duodiscus92/projet-gonogo/kicad/gonogo-light/gonogo-light.jpg

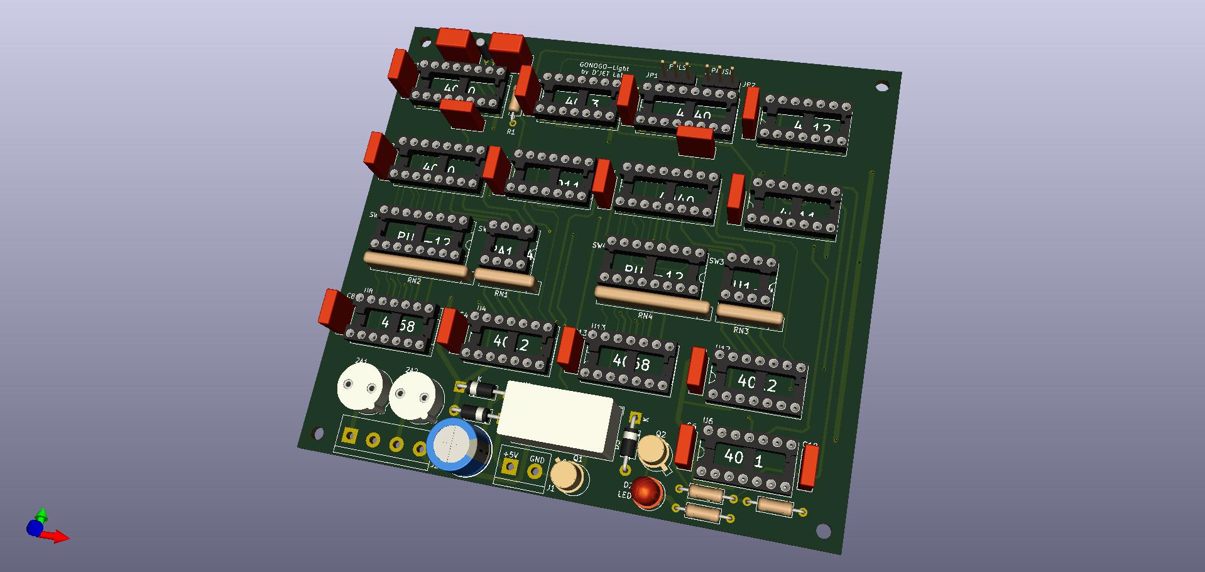
kicad/gonogo-light/gonogo-light.jpg
