duodiscus92/projet-gonogo/kicad/gonogo-heavy/gonogo-heavy.jpg

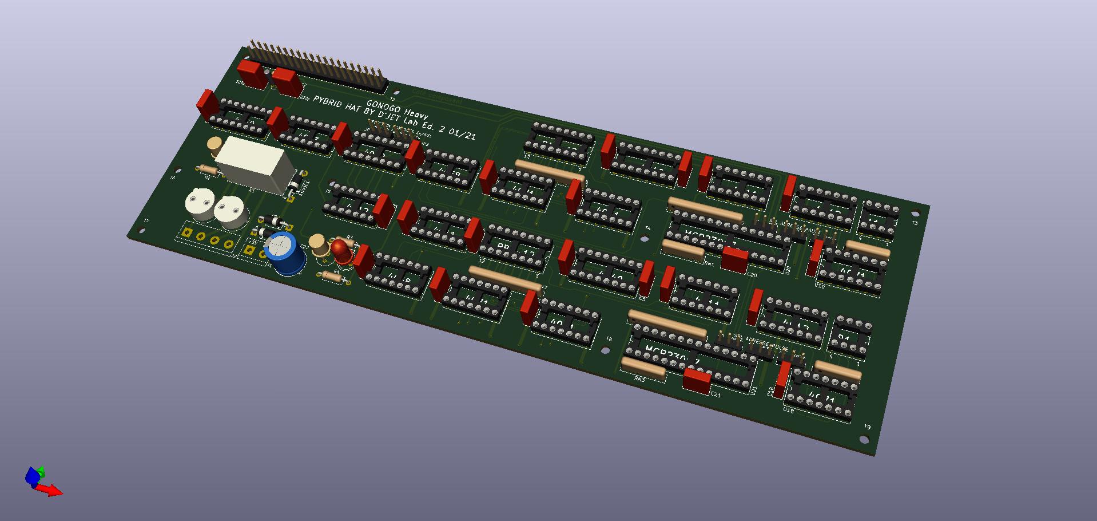
kicad/gonogo-heavy/gonogo-heavy.jpg
