duodiscus92/projet-gonogo/kicad/gonogo-upduino/gonogo-upduino/gongo.png

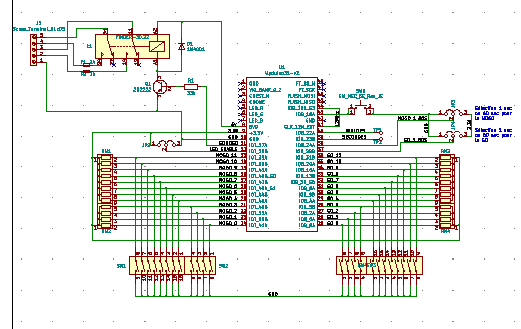
kicad/gonogo-upduino/gonogo-upduino/gongo.png
