duodiscus92/projet-gonogo/kicad/gonogo-upduino/gonogo-upduino/upduino-pinout.png

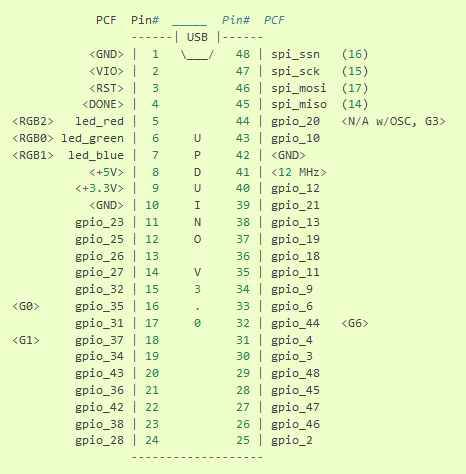
kicad/gonogo-upduino/gonogo-upduino/upduino-pinout.png
