duodiscus92/projet-gonogo/kicad/gonogo-upduino/gonogo-upduino/gonogo-upduino.kicad_pcb

## KiCad design kicad/gonogo-upduino/gonogo-upduino/gonogo-upduino.kicad_pcb (2022-09-14)

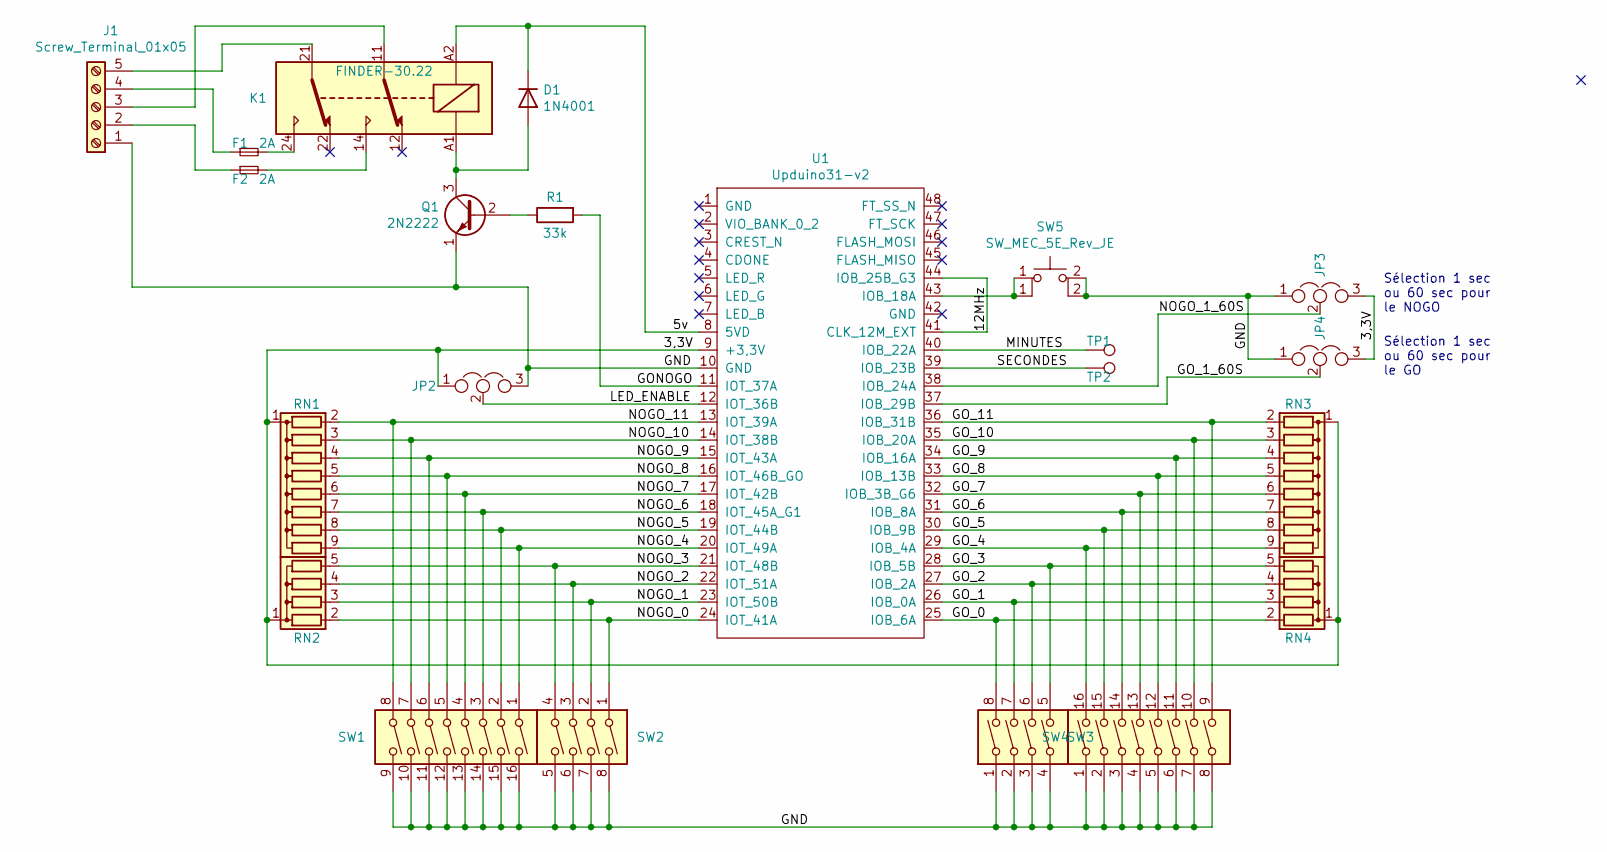
[picture p17: schematic gonogo-upduino.sch]

Parts:
D1: 1N4001; D_DO-41_SOD81_P10.16mm_Horizontal
F1, F2: 2A; Fuseholder_TR5_Littelfuse_No560_No460
J1: Screw_Terminal_01x05; TerminalBlock_bornier-5_P5.08mm
JP2, JP3, JP4: Jumper_NC_Dual; PinHeader_1x03_P2.54mm_Vertical
K1: FINDER-30.22; Relay_DPDT_Finder_30.22
Q1: 2N2222; TO-18-3
R1: 33k; R_Axial_DIN0207_L6.3mm_D2.5mm_P2.54mm_Vertical
RN1, RN3: R_Network08; R_Array_SIP9
RN2, RN4: R_Network04; R_Array_SIP5
SW1, SW4: SW_DIP_x08; DIP-16_W7.62mm_Socket
SW2, SW3: SW_DIP_x04; DIP-8_W7.62mm_Socket
SW5: SW_MEC_5E_Rev_JE; SW_PUSH_6mm
TP1, TP2: TestPoint; TestPoint_THTPad_3.0x3.0mm_Drill1.5mm
U1: Upduino31-v2; DIP-48_W17.78mm_LongPads

Connections:
/3,3V: JP2.1, JP3.3, JP4.3, RN1.1 (common), RN2.1 (common), RN3.1 (common), RN4.1 (common), U1.9 (+3,3V)
/5v: D1.1 (K), K1.A2, U1.8 (5VD)
/12MHz: U1.41 (CLK_12M_EXT), U1.44 (IOB_25B_G3)
/GND: J1.1, JP2.3, JP3.1, JP4.1, Q1.1 (E), SW1.9, SW1.10, SW1.11, SW1.12, SW1.13, SW1.14, SW1.15, SW1.16, SW2.5, SW2.6, SW2.7, SW2.8, SW3.1, SW3.2, SW3.3, SW3.4, SW4.1, SW4.2, SW4.3, SW4.4, SW4.5, SW4.6, SW4.7, SW4.8, SW5.2 (A), U1.10 (GND)
/GONOGO: R1.2, U1.11 (IOT_37A)
/GO_0: RN4.2 (R1), SW3.8, U1.25 (IOB_6A)
/GO_1: RN4.3 (R2), SW3.7, U1.26 (IOB_0A)
/GO_1_60S: JP4.2, U1.37 (IOB_29B)
/GO_2: RN4.4 (R3), SW3.6, U1.27 (IOB_2A)
/GO_3: RN4.5 (R4), SW3.5, U1.28 (IOB_5B)
/GO_4: RN3.9 (R8), SW4.16, U1.29 (IOB_4A)
/GO_5: RN3.8 (R7), SW4.15, U1.30 (IOB_9B)
/GO_6: RN3.7 (R6), SW4.14, U1.31 (IOB_8A)
/GO_7: RN3.6 (R5), SW4.13, U1.32 (IOB_3B_G6)
/GO_8: RN3.5 (R4), SW4.12, U1.33 (IOB_13B)
/GO_9: RN3.4 (R3), SW4.11, U1.34 (IOB_16A)
/GO_10: RN3.3 (R2), SW4.10, U1.35 (IOB_20A)
/GO_11: RN3.2 (R1), SW4.9, U1.36 (IOB_31B)
/LED_ENABLE: JP2.2, U1.12 (IOT_36B)
/MINUTES: TP1.1, U1.40 (IOB_22A)
/NOGO_0: RN2.2 (R1), SW2.1, U1.24 (IOT_41A)
/NOGO_1: RN2.3 (R2), SW2.2, U1.23 (IOT_50B)
/NOGO_1_60S: JP3.2, U1.38 (IOB_24A)
/NOGO_2: RN2.4 (R3), SW2.3, U1.22 (IOT_51A)
/NOGO_3: RN2.5 (R4), SW2.4, U1.21 (IOT_48B)
/NOGO_4: RN1.9 (R8), SW1.1, U1.20 (IOT_49A)
/NOGO_5: RN1.8 (R7), SW1.2, U1.19 (IOT_44B)
/NOGO_6: RN1.7 (R6), SW1.3, U1.18 (IOT_45A_G1)
/NOGO_7: RN1.6 (R5), SW1.4, U1.17 (IOT_42B)
/NOGO_8: RN1.5 (R4), SW1.5, U1.16 (IOT_46B_GO)
/NOGO_9: RN1.4 (R3), SW1.6, U1.15 (IOT_43A)
/NOGO_10: RN1.3 (R2), SW1.7, U1.14 (IOT_38B)
/NOGO_11: RN1.2 (R1), SW1.8, U1.13 (IOT_39A)
/SECONDES: TP2.1, U1.39 (IOB_23B)
unnamed: D1.2 (A), K1.A1, Q1.3 (C)
unnamed: F1.1, J1.4
unnamed: F1.2, K1.24
unnamed: F2.1, J1.2
unnamed: F2.2, K1.14
unnamed: J1.3, K1.11
unnamed: J1.5, K1.21
unnamed: Q1.2 (B), R1.1
unnamed: SW5.1, U1.43 (IOB_18A)

Notes on the sheet:
Sélection 1 sec ou 60 sec pour le NOGO
Sélection 1 sec ou 60 sec pour le GO

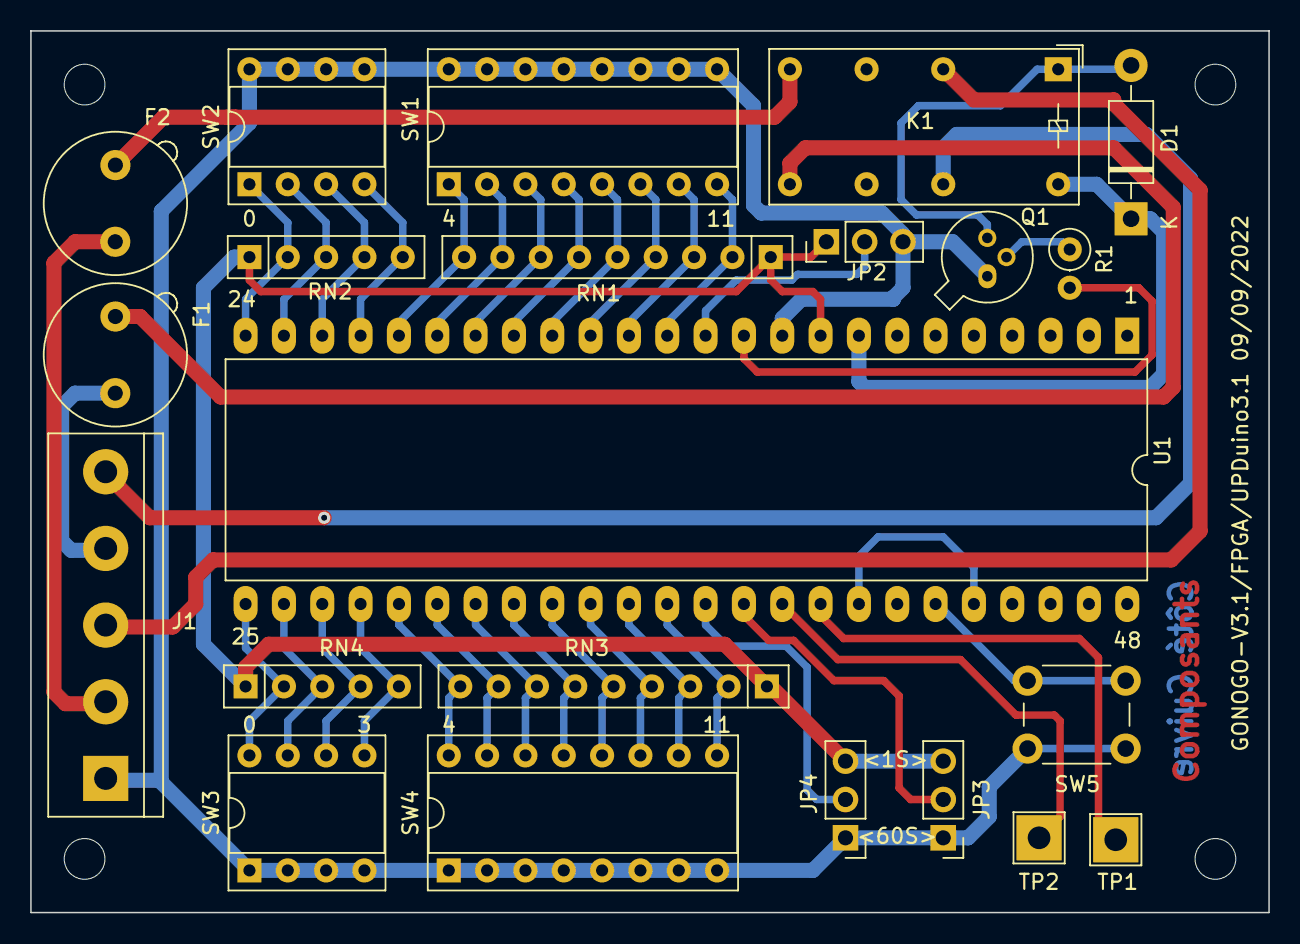
[picture p18: board gonogo-upduino.kicad_pcb from above]

Board: 2 copper layers, 82.0 x 58.4 mm, 23 parts (0 on the bottom side), 43 nets.

Other parts of the board:
NOGO-0: MountingHole_2.7mm_M2.5_DIN965
