duodiscus92/projet-gonogo/kicad/gonogo-heavy/timer-toplevel.kicad_pcb

## KiCad design kicad/gonogo-heavy/timer-toplevel.kicad_pcb (2021-02-23)

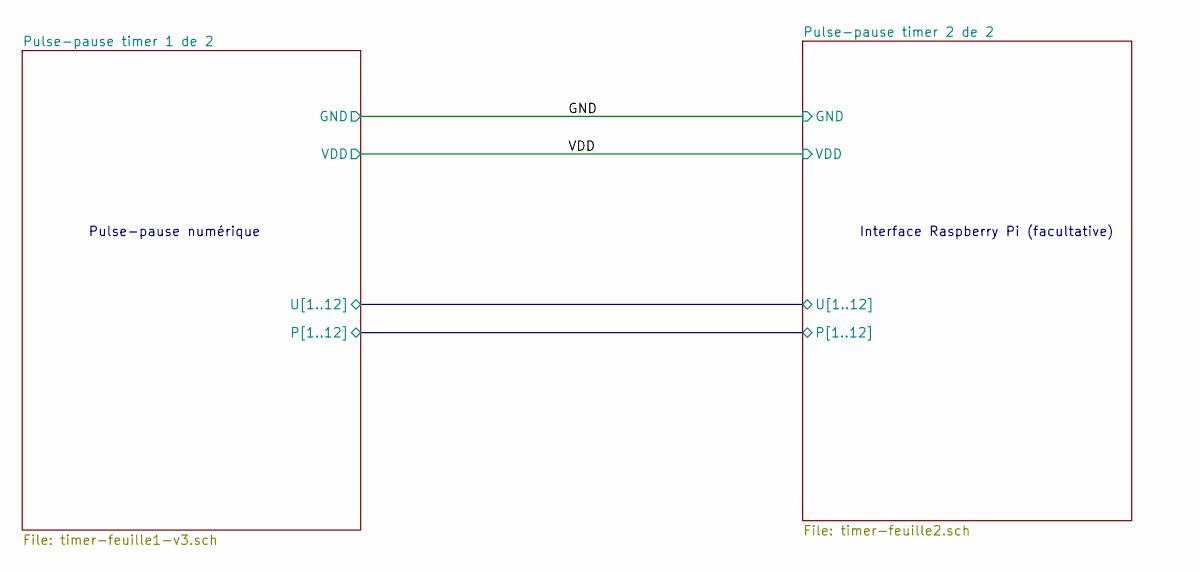
[picture p19: schematic timer-toplevel.sch, GONOGO Heavy]

Notes on the sheet:
Interface Raspberry Pi (facultative)
Pulse-pause numérique

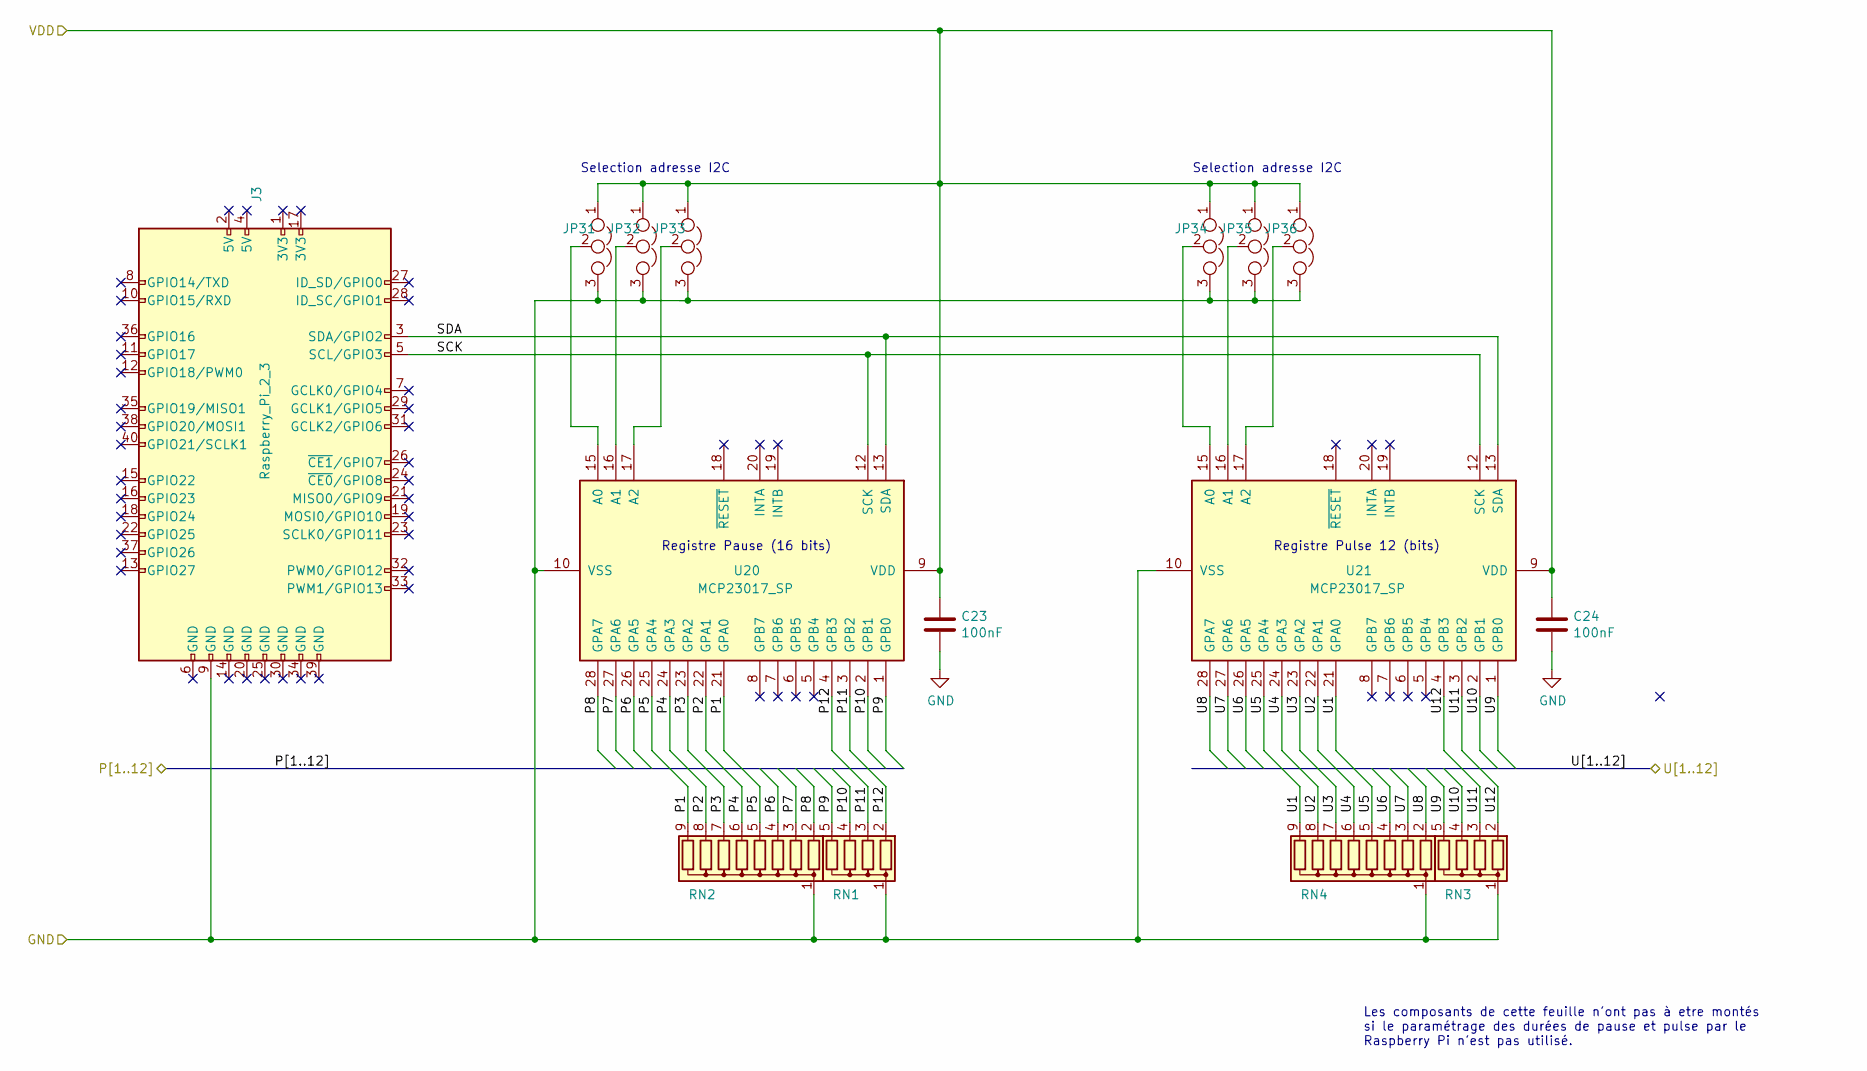
[picture p20: schematic timer-feuille2.sch, GONOGO Heavy]

Parts:
C23, C24: 100nF; C_Rect_L7.2mm_W2.5mm_P5.00mm_FKS2_FKP2_MKS2_MKP2
J3: Raspberry_Pi_2_3; PinHeader_2x20_P2.54mm_Vertical
JP31, JP32, JP33, JP34, JP35, JP36: Jumper_NC_Dual; PinHeader_1x03_P2.54mm_Vertical
RN1, RN3: R_Network04; R_Array_SIP5
RN2, RN4: R_Network08; R_Array_SIP9
U20, U21: MCP23017_SP; DIP-28_W7.62mm_Socket

Connections:
/Pulse-pause timer 1 de 2/P1: RN2.9 (R8), U20.21 (GPA0); also elsewhere on the board
/Pulse-pause timer 1 de 2/P2: RN2.8 (R7), U20.22 (GPA1); also elsewhere on the board
/Pulse-pause timer 1 de 2/P3: RN2.7 (R6), U20.23 (GPA2); also elsewhere on the board
/Pulse-pause timer 1 de 2/P4: RN2.6 (R5), U20.24 (GPA3); also elsewhere on the board
/Pulse-pause timer 1 de 2/P5: RN2.5 (R4), U20.25 (GPA4); also elsewhere on the board
/Pulse-pause timer 1 de 2/P6: RN2.4 (R3), U20.26 (GPA5); also elsewhere on the board
/Pulse-pause timer 1 de 2/P7: RN2.3 (R2), U20.27 (GPA6); also elsewhere on the board
/Pulse-pause timer 1 de 2/P8: RN2.2 (R1), U20.28 (GPA7); also elsewhere on the board
/Pulse-pause timer 1 de 2/P9: RN1.5 (R4), U20.1 (GPB0); also elsewhere on the board
/Pulse-pause timer 1 de 2/P10: RN1.4 (R3), U20.2 (GPB1); also elsewhere on the board
/Pulse-pause timer 1 de 2/P11: RN1.3 (R2), U20.3 (GPB2); also elsewhere on the board
/Pulse-pause timer 1 de 2/P12: RN1.2 (R1), U20.4 (GPB3); also elsewhere on the board
/Pulse-pause timer 1 de 2/U1: RN4.9 (R8), U21.21 (GPA0); also elsewhere on the board
/Pulse-pause timer 1 de 2/U2: RN4.8 (R7), U21.22 (GPA1); also elsewhere on the board
/Pulse-pause timer 1 de 2/U3: RN4.7 (R6), U21.23 (GPA2); also elsewhere on the board
/Pulse-pause timer 1 de 2/U4: RN4.6 (R5), U21.24 (GPA3); also elsewhere on the board
/Pulse-pause timer 1 de 2/U5: RN4.5 (R4), U21.25 (GPA4); also elsewhere on the board
/Pulse-pause timer 1 de 2/U6: RN4.4 (R3), U21.26 (GPA5); also elsewhere on the board
/Pulse-pause timer 1 de 2/U7: RN4.3 (R2), U21.27 (GPA6); also elsewhere on the board
/Pulse-pause timer 1 de 2/U8: RN4.2 (R1), U21.28 (GPA7); also elsewhere on the board
/Pulse-pause timer 1 de 2/U9: RN3.5 (R4), U21.1 (GPB0); also elsewhere on the board
/Pulse-pause timer 1 de 2/U10: RN3.4 (R3), U21.2 (GPB1); also elsewhere on the board
/Pulse-pause timer 1 de 2/U11: RN3.3 (R2), U21.3 (GPB2); also elsewhere on the board
/Pulse-pause timer 1 de 2/U12: RN3.2 (R1), U21.4 (GPB3); also elsewhere on the board
/Pulse-pause timer 2 de 2/SCK: J3.5 (SCL/GPIO3), U20.12 (SCK), U21.12 (SCK)
/Pulse-pause timer 2 de 2/SDA: J3.3 (SDA/GPIO2), U20.13 (SDA), U21.13 (SDA)
GND: C23.2, C24.2, J3.9 (GND), JP31.3, JP32.3, JP33.3, JP34.3, JP35.3, JP36.3, RN1.1 (common), RN2.1 (common), RN3.1 (common), RN4.1 (common), U20.10 (VSS), U21.10 (VSS); also elsewhere on the board
unnamed: JP31.2, U20.15 (A0)
unnamed: JP32.2, U20.16 (A1)
unnamed: JP33.2, U20.17 (A2)
unnamed: JP34.2, U21.15 (A0)
unnamed: JP35.2, U21.16 (A1)
unnamed: JP36.2, U21.17 (A2)
VDD: C23.1, C24.1, JP31.1, JP32.1, JP33.1, JP34.1, JP35.1, JP36.1, U20.9 (VDD), U21.9 (VDD); also elsewhere on the board

Notes on the sheet:
Registre Pause (16 bits)
Registre Pulse 12 (bits)
Les composants de cette feuille n'ont pas à etre montés si le paramétrage des durées de pause et pulse par le Raspberry Pi n'est pas utilisé.
Selection adresse I2C

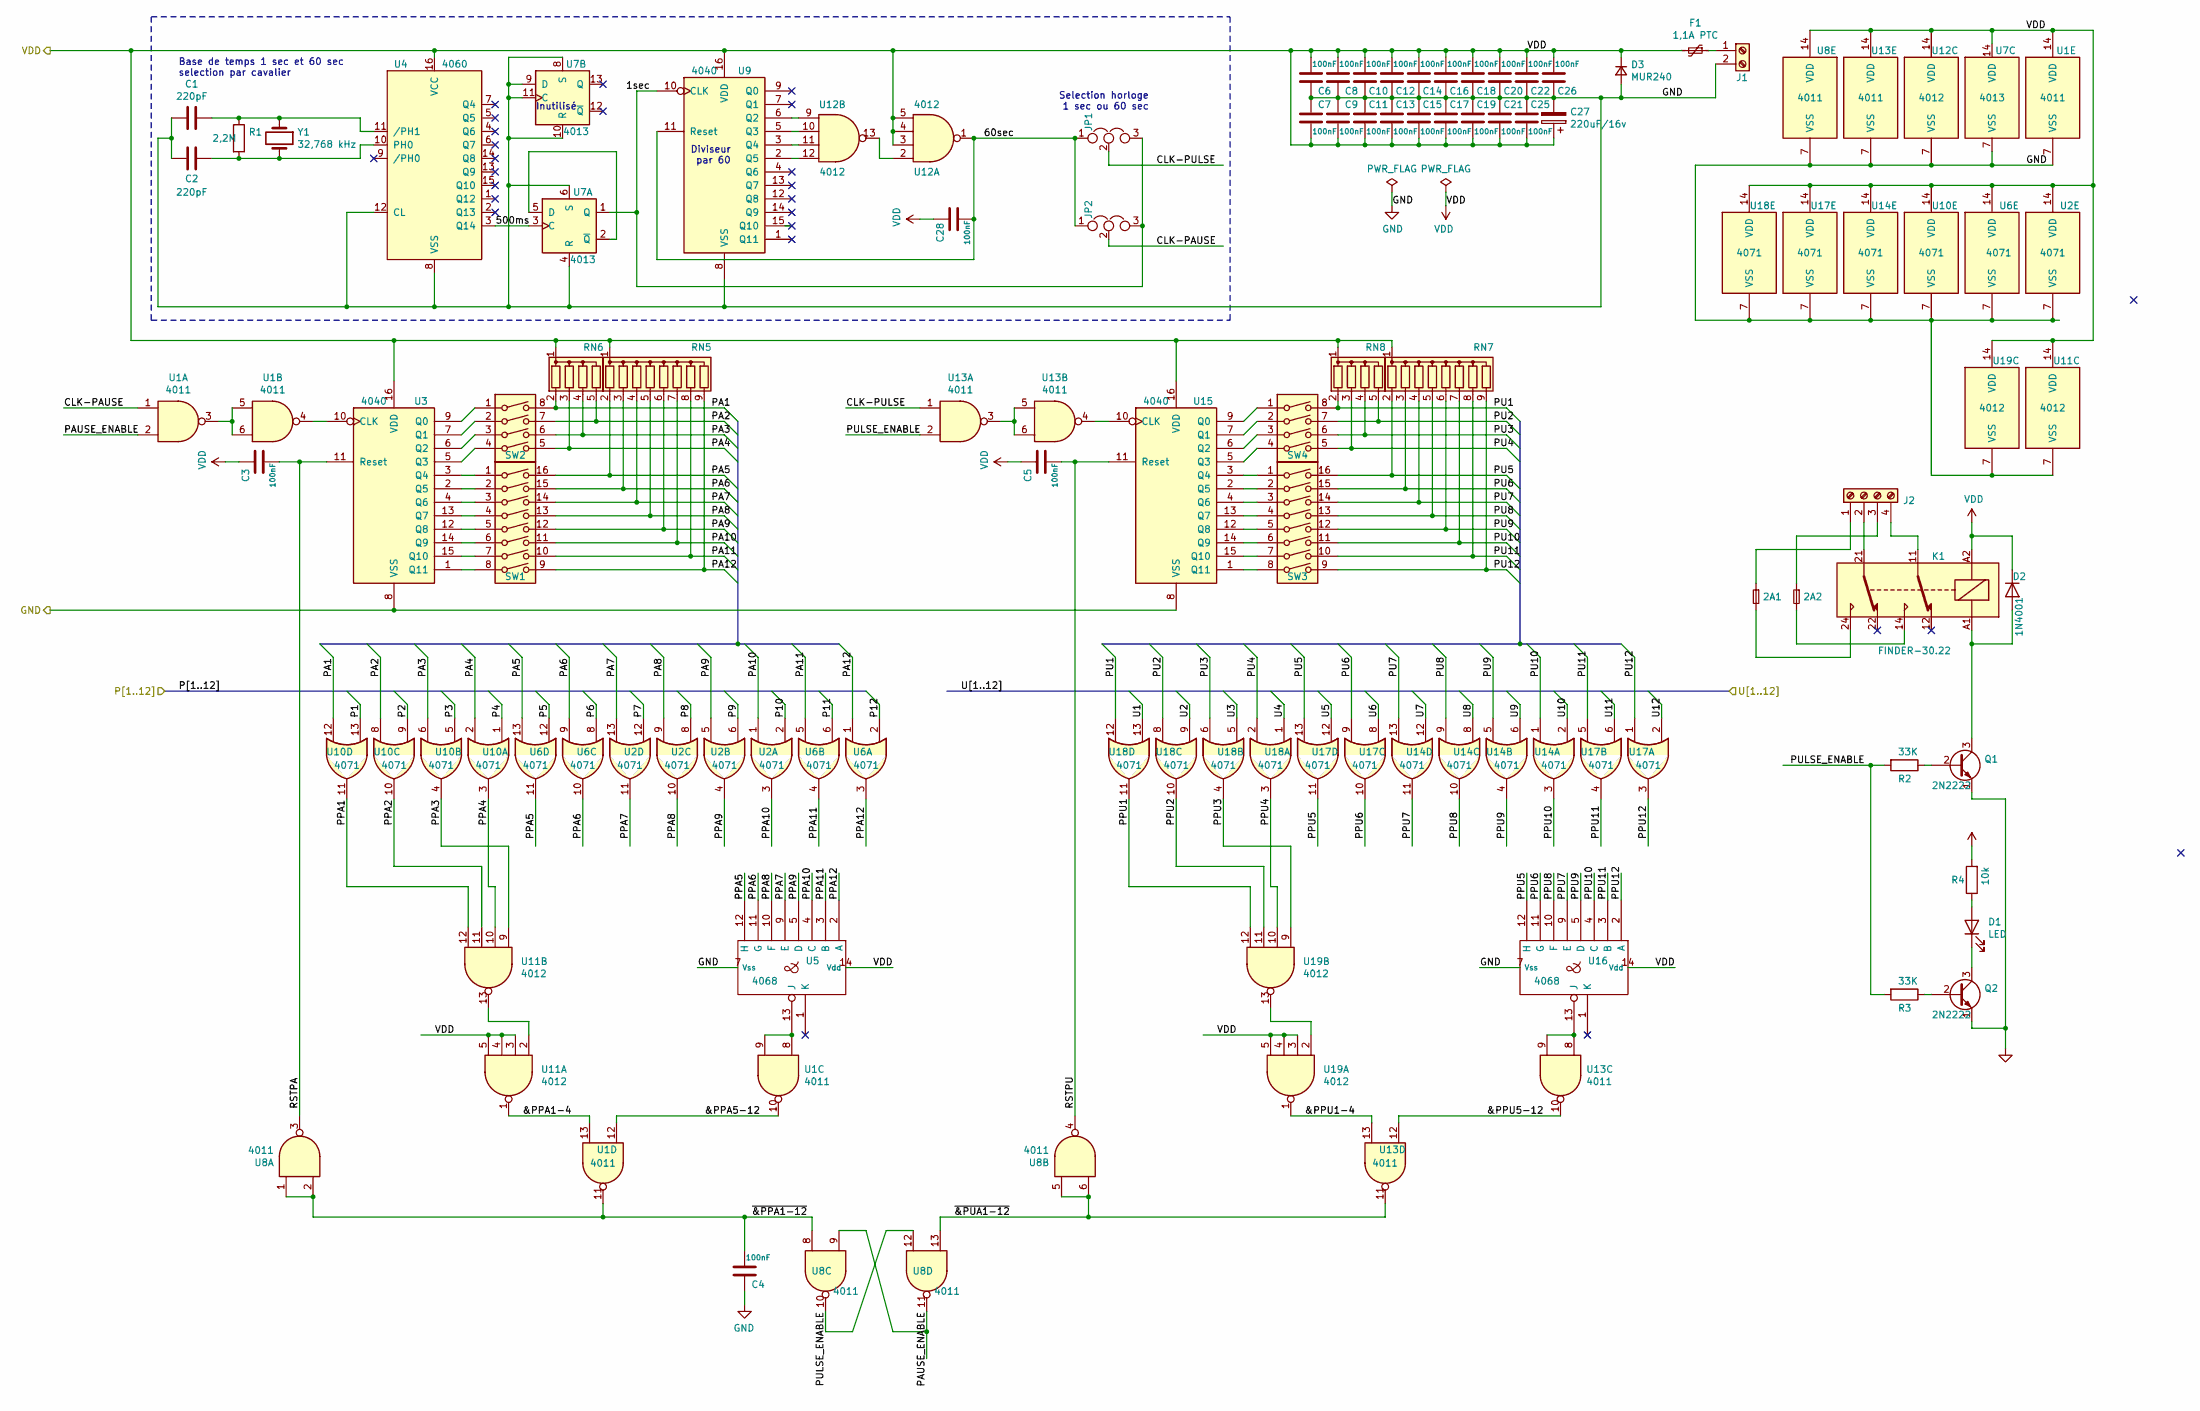
[picture p21: schematic timer-feuille1-v3.sch, GONOGO Heavy]

Parts:
2A1, 2A2: Fuse_Small; Fuseholder_TR5_Littelfuse_No560_No460
C1, C2: 220pF; C_Rect_L7.2mm_W4.5mm_P5.00mm_FKS2_FKP2_MKS2_MKP2
C3, C4, C5, C6, C7, C8, C9, C10, C11, C12, C13, C14, C15, C16, C17, C18, C19, C20, C21, C22, C25, C26, C28: 100nF; C_Rect_L7.2mm_W2.5mm_P5.00mm_FKS2_FKP2_MKS2_MKP2
C27: 220uF/16v; CP_Radial_D10.0mm_P5.00mm
D1: LED; LED_D5.0mm
D2: 1N4001; D_DO-41_SOD81_P10.16mm_Horizontal
D3: MUR240; D_DO-41_SOD81_P10.16mm_Horizontal
F1: 1,1A PTC; D_DO-41_SOD81_P10.16mm_Horizontal
J1: Screw_Terminal_01x02; TerminalBlock_bornier-2_P5.08mm
J2: Screw_Terminal_01x04; TerminalBlock_bornier-4_P5.08mm
JP1, JP2: Jumper_NC_Dual; PinHeader_1x03_P2.54mm_Vertical
K1: FINDER-30.22; Relay_DPDT_Finder_30.22
Q1, Q2: 2N2222; TO-18-3
R1: 2,2M; R_Axial_DIN0207_L6.3mm_D2.5mm_P10.16mm_Horizontal
R2, R3: 33K; R_Axial_DIN0207_L6.3mm_D2.5mm_P10.16mm_Horizontal
R4: 10k; R_Axial_DIN0207_L6.3mm_D2.5mm_P10.16mm_Horizontal
RN5, RN7: R_Network08; R_Array_SIP9
RN6, RN8: R_Network04; R_Array_SIP5
SW1, SW3: SW_DIP_x08; DIP-16_W7.62mm_Socket
SW2, SW4: SW_DIP_x04; DIP-8_W7.62mm_Socket
U1, U8, U13: 4011; DIP-14_W7.62mm_Socket
U2, U6, U10, U14, U17, U18: 4071; DIP-14_W7.62mm_Socket
U3, U9, U15: 4040; DIP-16_W7.62mm_Socket
U4: 4060; DIP-16_W7.62mm_Socket
U5, U16: 4068; DIP-14_W7.62mm_Socket
U7: 4013; DIP-14_W7.62mm_Socket
U11, U12, U19: 4012; DIP-14_W7.62mm_Socket
Y1: 32,768 kHz; Crystal_C26-LF_D2.1mm_L6.5mm_Vertical

Connections:
/Pulse-pause timer 1 de 2/1sec: JP1.3, JP2.3, U7.1 (Q), U9.10 (CLK)
/Pulse-pause timer 1 de 2/60sec: C28.2, JP1.1, JP2.1, U9.11 (Reset), U12.1
/Pulse-pause timer 1 de 2/500ms: U4.3 (Q14), U7.3 (C)
/Pulse-pause timer 1 de 2/&PPA1-4: U1.13, U11.1
/Pulse-pause timer 1 de 2/&PPA5-12: U1.10, U1.12
/Pulse-pause timer 1 de 2/&PPU1-4: U13.13, U19.1
/Pulse-pause timer 1 de 2/&PPU5-12: U13.10, U13.12
/Pulse-pause timer 1 de 2/CLK-PAUSE: JP2.2, U1.1
/Pulse-pause timer 1 de 2/CLK-PULSE: JP1.2, U13.1
/Pulse-pause timer 1 de 2/P1: U10.13; also elsewhere on the board
/Pulse-pause timer 1 de 2/P2: U10.9; also elsewhere on the board
/Pulse-pause timer 1 de 2/P3: U10.5; also elsewhere on the board
/Pulse-pause timer 1 de 2/P4: U10.1; also elsewhere on the board
/Pulse-pause timer 1 de 2/P5: U6.12; also elsewhere on the board
/Pulse-pause timer 1 de 2/P6: U6.8; also elsewhere on the board
/Pulse-pause timer 1 de 2/P7: U2.12; also elsewhere on the board
/Pulse-pause timer 1 de 2/P8: U2.8; also elsewhere on the board
/Pulse-pause timer 1 de 2/P9: U2.6; also elsewhere on the board
/Pulse-pause timer 1 de 2/P10: U2.2; also elsewhere on the board
/Pulse-pause timer 1 de 2/P11: U6.6; also elsewhere on the board
/Pulse-pause timer 1 de 2/P12: U6.2; also elsewhere on the board
/Pulse-pause timer 1 de 2/PA1: RN6.2 (R1), SW2.8, U10.12
/Pulse-pause timer 1 de 2/PA2: RN6.5 (R4), SW2.7, U10.8
/Pulse-pause timer 1 de 2/PA3: RN6.4 (R3), SW2.6, U10.6
/Pulse-pause timer 1 de 2/PA4: RN6.3 (R2), SW2.5, U10.2
/Pulse-pause timer 1 de 2/PA5: RN5.2 (R1), SW1.16, U6.13
/Pulse-pause timer 1 de 2/PA6: RN5.3 (R2), SW1.15, U6.9
/Pulse-pause timer 1 de 2/PA7: RN5.4 (R3), SW1.14, U2.13
/Pulse-pause timer 1 de 2/PA8: RN5.5 (R4), SW1.13, U2.9
/Pulse-pause timer 1 de 2/PA9: RN5.6 (R5), SW1.12, U2.5
/Pulse-pause timer 1 de 2/PA10: RN5.7 (R6), SW1.11, U2.1
/Pulse-pause timer 1 de 2/PA11: RN5.8 (R7), SW1.10, U6.5
/Pulse-pause timer 1 de 2/PA12: RN5.9 (R8), SW1.9, U6.1
/Pulse-pause timer 1 de 2/PAUSE_ENABLE: U1.2, U8.9, U8.11
/Pulse-pause timer 1 de 2/PPA1: U10.11, U11.12
/Pulse-pause timer 1 de 2/PPA2: U10.10, U11.11
/Pulse-pause timer 1 de 2/PPA3: U10.4, U11.9
/Pulse-pause timer 1 de 2/PPA4: U10.3, U11.10
/Pulse-pause timer 1 de 2/PPA5: U5.12 (H), U6.11
/Pulse-pause timer 1 de 2/PPA6: U5.11 (G), U6.10
/Pulse-pause timer 1 de 2/PPA7: U2.11, U5.9 (E)
/Pulse-pause timer 1 de 2/PPA8: U2.10, U5.10 (F)
/Pulse-pause timer 1 de 2/PPA9: U2.4, U5.5 (D)
/Pulse-pause timer 1 de 2/PPA10: U2.3, U5.4 (C)
/Pulse-pause timer 1 de 2/PPA11: U5.3 (B), U6.4
/Pulse-pause timer 1 de 2/PPA12: U5.2 (A), U6.3
/Pulse-pause timer 1 de 2/PPU1: U18.11, U19.12
/Pulse-pause timer 1 de 2/PPU2: U18.10, U19.11
/Pulse-pause timer 1 de 2/PPU3: U18.4, U19.9
/Pulse-pause timer 1 de 2/PPU4: U18.3, U19.10
/Pulse-pause timer 1 de 2/PPU5: U16.12 (H), U17.11
/Pulse-pause timer 1 de 2/PPU6: U16.11 (G), U17.10
/Pulse-pause timer 1 de 2/PPU7: U14.11, U16.9 (E)
/Pulse-pause timer 1 de 2/PPU8: U14.10, U16.10 (F)
/Pulse-pause timer 1 de 2/PPU9: U14.4, U16.5 (D)
/Pulse-pause timer 1 de 2/PPU10: U14.3, U16.4 (C)
/Pulse-pause timer 1 de 2/PPU11: U16.3 (B), U17.4
/Pulse-pause timer 1 de 2/PPU12: U16.2 (A), U17.3
/Pulse-pause timer 1 de 2/PU1: RN8.2 (R1), SW4.8, U18.12
/Pulse-pause timer 1 de 2/PU2: RN8.5 (R4), SW4.7, U18.8
/Pulse-pause timer 1 de 2/PU3: RN8.4 (R3), SW4.6, U18.6
/Pulse-pause timer 1 de 2/PU4: RN8.3 (R2), SW4.5, U18.2
/Pulse-pause timer 1 de 2/PU5: RN7.2 (R1), SW3.16, U17.13
/Pulse-pause timer 1 de 2/PU6: RN7.3 (R2), SW3.15, U17.9
/Pulse-pause timer 1 de 2/PU7: RN7.4 (R3), SW3.14, U14.13
/Pulse-pause timer 1 de 2/PU8: RN7.5 (R4), SW3.13, U14.9
/Pulse-pause timer 1 de 2/PU9: RN7.6 (R5), SW3.12, U14.5
/Pulse-pause timer 1 de 2/PU10: RN7.7 (R6), SW3.11, U14.1
/Pulse-pause timer 1 de 2/PU11: RN7.8 (R7), SW3.10, U17.5
/Pulse-pause timer 1 de 2/PU12: RN7.9 (R8), SW3.9, U17.1
/Pulse-pause timer 1 de 2/PULSE_ENABLE: R2.2, R3.2, U8.10, U8.12, U13.2
/Pulse-pause timer 1 de 2/RSTPA: C3.2, U3.11 (Reset), U8.3
/Pulse-pause timer 1 de 2/RSTPU: C5.2, U8.4, U15.11 (Reset)
/Pulse-pause timer 1 de 2/U1: U18.13; also elsewhere on the board
/Pulse-pause timer 1 de 2/U2: U18.9; also elsewhere on the board
/Pulse-pause timer 1 de 2/U3: U18.5; also elsewhere on the board
/Pulse-pause timer 1 de 2/U4: U18.1; also elsewhere on the board
/Pulse-pause timer 1 de 2/U5: U17.12; also elsewhere on the board
/Pulse-pause timer 1 de 2/U6: U17.8; also elsewhere on the board
/Pulse-pause timer 1 de 2/U7: U14.12; also elsewhere on the board
/Pulse-pause timer 1 de 2/U8: U14.8; also elsewhere on the board
/Pulse-pause timer 1 de 2/U9: U14.6; also elsewhere on the board
/Pulse-pause timer 1 de 2/U10: U14.2; also elsewhere on the board
/Pulse-pause timer 1 de 2/U11: U17.6; also elsewhere on the board
/Pulse-pause timer 1 de 2/U12: U17.2; also elsewhere on the board
/Pulse-pause timer 1 de 2/~&PPA1-12: C4.2, U1.11, U8.1, U8.2, U8.8
/Pulse-pause timer 1 de 2/~&PUA1-12: U8.5, U8.6, U8.13, U13.11
GND: C1.2, C2.2, C4.1, C6.1, C7.1, C8.1, C9.1, C10.1, C11.1, C12.1, C13.1, C14.1, C15.1, C16.1, C17.1, C18.1, C19.1, C20.1, C21.1, C22.1, C25.1, C26.1, C27.2, D3.2 (A), J1.2, Q1.1 (E), Q2.1 (E), U1.7 (VSS), U2.7 (VSS), U3.8 (VSS), U4.8 (VSS), U4.12 (CL), U5.7 (Vss), U6.7 (VSS), U7.4 (R), U7.6 (S), U7.7 (VSS), U7.8 (S), U7.9 (D), U7.10 (R), U7.11 (C), U8.7 (VSS), U9.8 (VSS), U10.7 (VSS), U11.7 (VSS), U12.7 (VSS), U13.7 (VSS), U14.7 (VSS), U15.8 (VSS), U16.7 (Vss), U17.7 (VSS), U18.7 (VSS), U19.7 (VSS); also elsewhere on the board
unnamed: 2A1.1, J2.1
unnamed: 2A1.2, K1.24
unnamed: 2A2.1, J2.3
unnamed: 2A2.2, K1.14
unnamed: C1.1, R1.1, U4.11 (/PH1), Y1.1
unnamed: C2.1, R1.2, U4.10 (PH0), Y1.2
unnamed: D1.1 (K), Q2.3 (C)
unnamed: D1.2 (A), R4.1
unnamed: D2.2 (A), K1.A1, Q1.3 (C)
unnamed: F1.1, J1.1
unnamed: J2.2, K1.21
unnamed: J2.4, K1.11
unnamed: Q1.2 (B), R2.1
unnamed: Q2.2 (B), R3.1
unnamed: SW1.1, U3.3 (Q4)
unnamed: SW1.2, U3.2 (Q5)
unnamed: SW1.3, U3.4 (Q6)
unnamed: SW1.4, U3.13 (Q7)
unnamed: SW1.5, U3.12 (Q8)
unnamed: SW1.6, U3.14 (Q9)
unnamed: SW1.7, U3.15 (Q10)
unnamed: SW1.8, U3.1 (Q11)
unnamed: SW2.1, U3.9 (Q0)
unnamed: SW2.2, U3.7 (Q1)
unnamed: SW2.3, U3.6 (Q2)
unnamed: SW2.4, U3.5 (Q3)
unnamed: SW3.1, U15.3 (Q4)
unnamed: SW3.2, U15.2 (Q5)
unnamed: SW3.3, U15.4 (Q6)
unnamed: SW3.4, U15.13 (Q7)
unnamed: SW3.5, U15.12 (Q8)
unnamed: SW3.6, U15.14 (Q9)
unnamed: SW3.7, U15.15 (Q10)
unnamed: SW3.8, U15.1 (Q11)
unnamed: SW4.1, U15.9 (Q0)
unnamed: SW4.2, U15.7 (Q1)
unnamed: SW4.3, U15.6 (Q2)
unnamed: SW4.4, U15.5 (Q3)
unnamed: U1.3, U1.5, U1.6
unnamed: U1.4, U3.10 (CLK)
unnamed: U1.8, U1.9, U5.13 (J)
unnamed: U7.2 (~Q), U7.5 (D)
unnamed: U11.2, U11.13
unnamed: U9.6 (Q2), U12.9
unnamed: U9.5 (Q3), U12.10
unnamed: U9.3 (Q4), U12.11
unnamed: U9.2 (Q5), U12.12
unnamed: U12.2, U12.13
unnamed: U13.3, U13.5, U13.6
unnamed: U13.4, U15.10 (CLK)
unnamed: U13.8, U13.9, U16.13 (J)
unnamed: U19.2, U19.13
VDD: C3.1, C5.1, C6.2, C7.2, C8.2, C9.2, C10.2, C11.2, C12.2, C13.2, C14.2, C15.2, C16.2, C17.2, C18.2, C19.2, C20.2, C21.2, C22.2, C25.2, C26.2, C27.1, C28.1, D2.1 (K), D3.1 (K), F1.2, K1.A2, R4.2, RN5.1 (common), RN6.1 (common), RN7.1 (common), RN8.1 (common), U1.14 (VDD), U2.14 (VDD), U3.16 (VDD), U4.16 (VCC), U5.14 (Vdd), U6.14 (VDD), U7.14 (VDD), U8.14 (VDD), U9.16 (VDD), U10.14 (VDD), U11.3, U11.4, U11.5, U11.14 (VDD), U12.3, U12.4, U12.5, U12.14 (VDD), U13.14 (VDD), U14.14 (VDD), U15.16 (VDD), U16.14 (Vdd), U17.14 (VDD), U18.14 (VDD), U19.3, U19.4, U19.5, U19.14 (VDD); also elsewhere on the board

Notes on the sheet:
Base de temps 1 sec et 60 sec selection par cavalier
Inutilisé
Diviseur par 60
Selection horloge 1 sec ou 60 sec

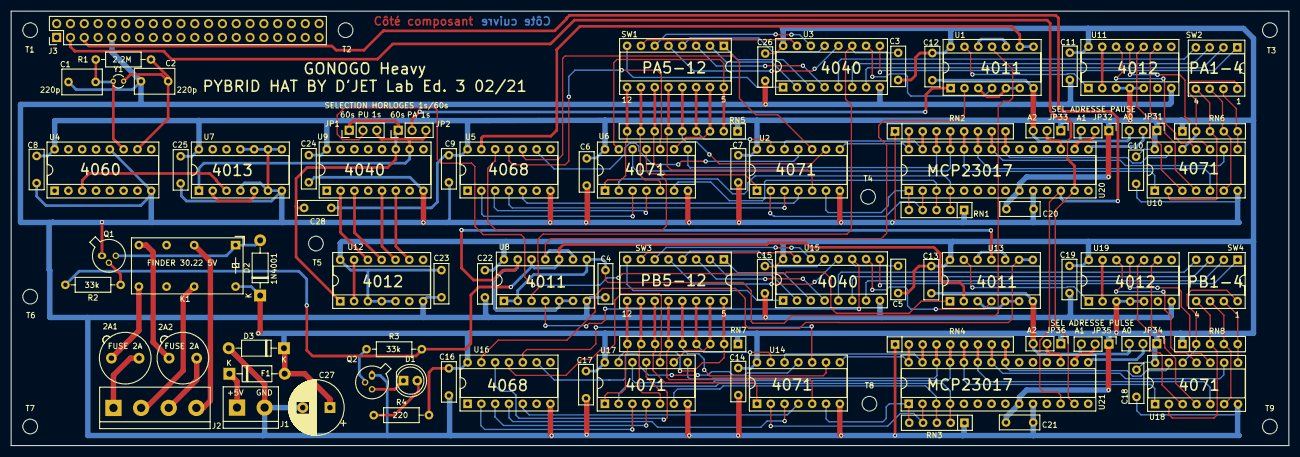
[picture p22: board timer-toplevel.kicad_pcb from above]

Board: 2 copper layers, 234.9 x 79.9 mm, 95 parts (0 on the bottom side), 149 nets.

Other parts of the board:
T1, T2, T3, T4, T5, T6, T7, T8, T9: MountingHole_2.7mm_M2.5_DIN965
