duodiscus92/projet-gonogo/kicad/gonogo-light/timer-light.kicad_pcb

## KiCad design kicad/gonogo-light/timer-light.kicad_pcb (2021-02-23)

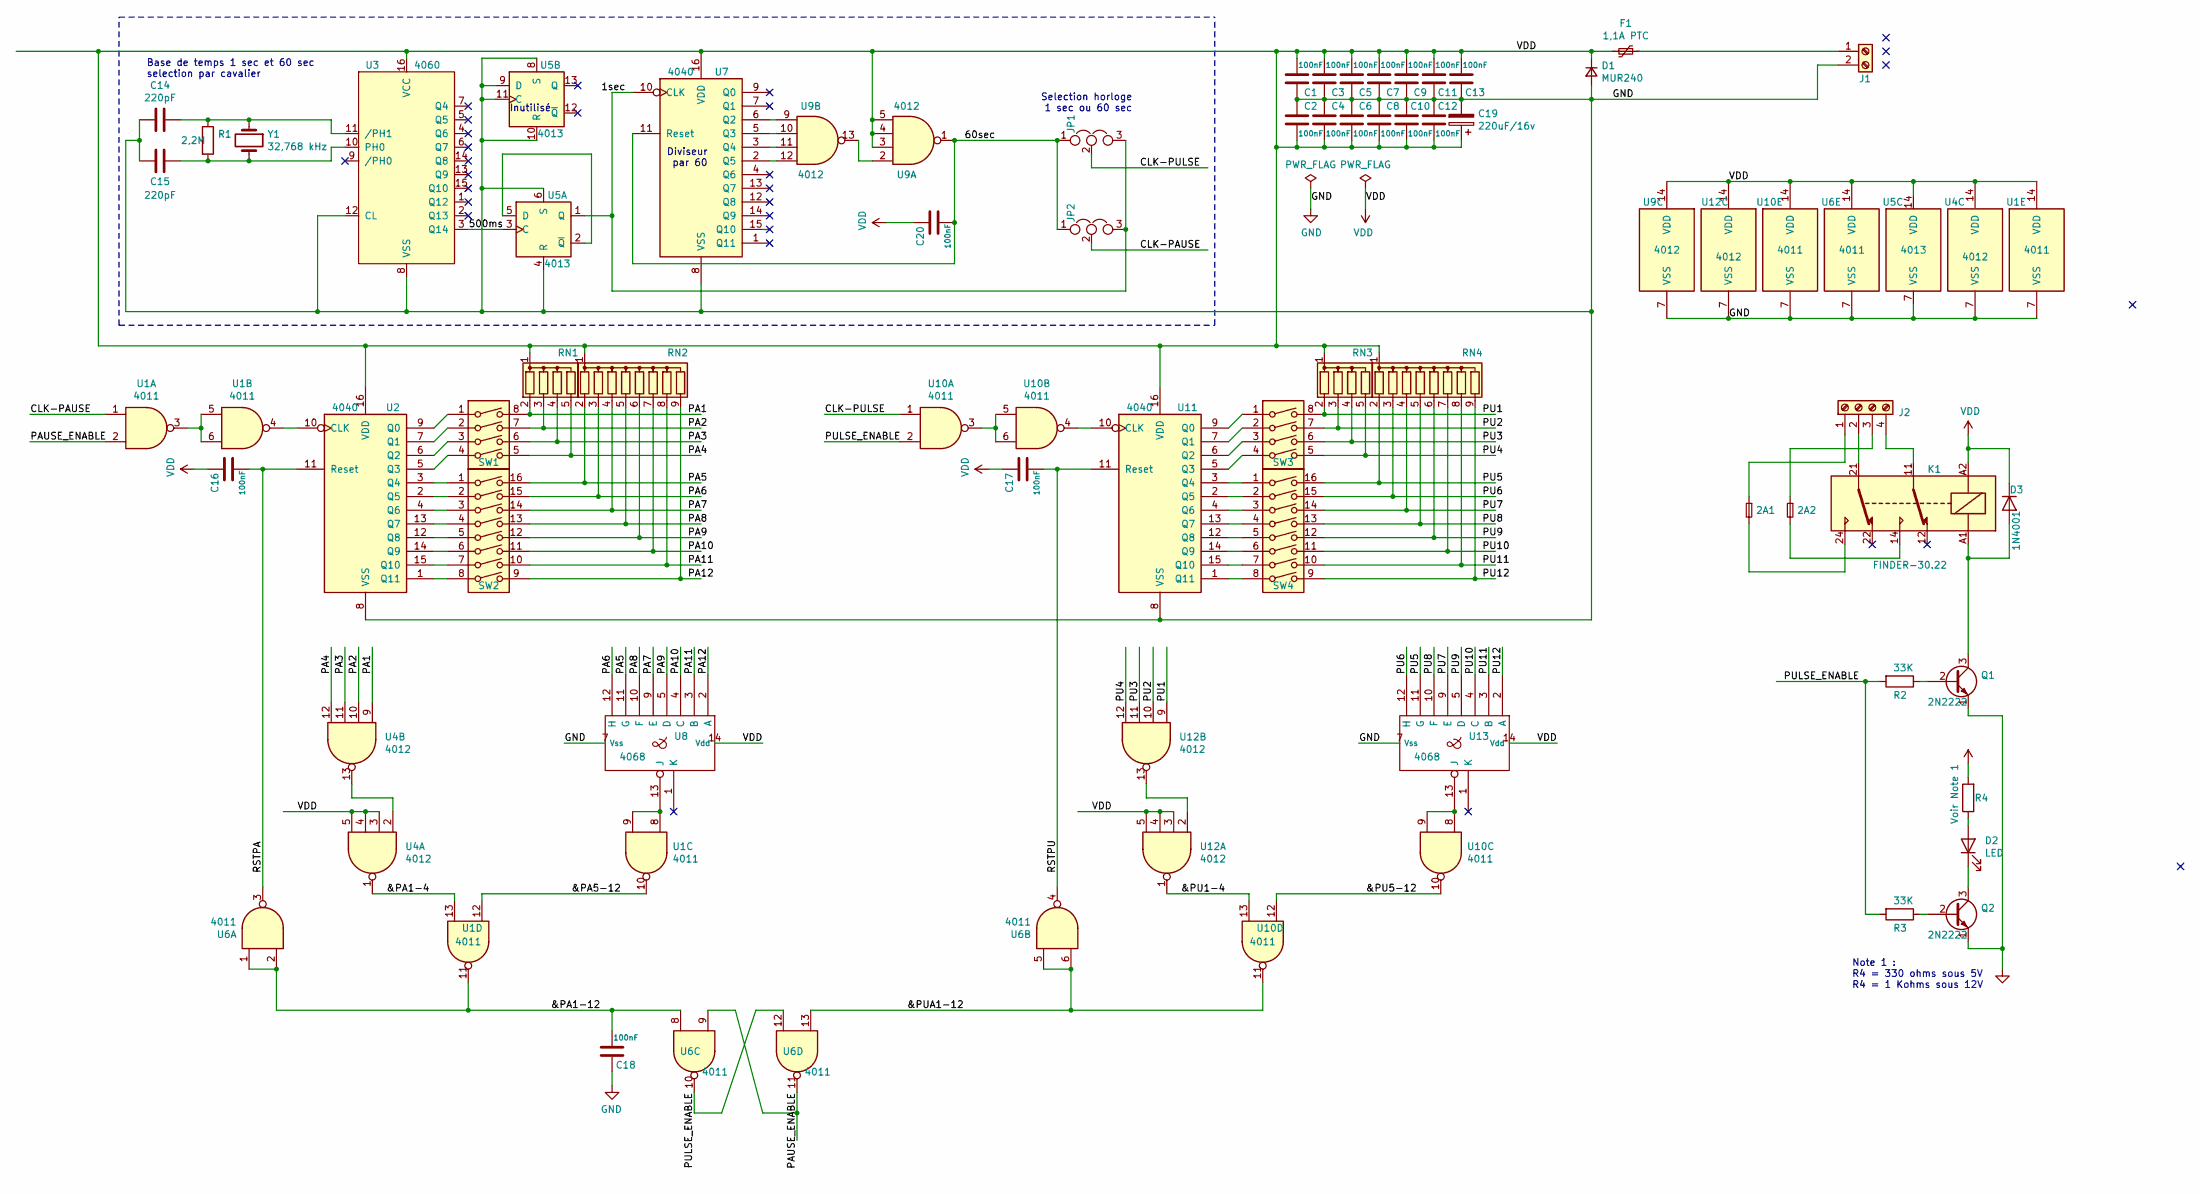
[picture p23: schematic timer-light.sch, GONOGO Light]

Parts:
2A1, 2A2: Fuse_Small; Fuseholder_TR5_Littelfuse_No560_No460
C1, C2, C3, C4, C5, C6, C7, C8, C9, C10, C11, C12, C13, C16, C17, C18, C20: 100nF; C_Rect_L7.2mm_W2.5mm_P5.00mm_FKS2_FKP2_MKS2_MKP2
C14, C15: 220pF; C_Rect_L7.2mm_W4.5mm_P5.00mm_FKS2_FKP2_MKS2_MKP2
C19: 220uF/16v; CP_Radial_D10.0mm_P5.00mm
D1: MUR240; D_DO-41_SOD81_P10.16mm_Horizontal
D2: LED; LED_D5.0mm
D3: 1N4001; D_DO-41_SOD81_P10.16mm_Horizontal
F1: 1,1A PTC; D_DO-41_SOD81_P10.16mm_Horizontal
J1: Screw_Terminal_01x02; TerminalBlock_bornier-2_P5.08mm
J2: Screw_Terminal_01x04; TerminalBlock_bornier-4_P5.08mm
JP1, JP2: Jumper_NC_Dual; PinHeader_1x03_P2.54mm_Vertical
K1: FINDER-30.22; Relay_DPDT_Finder_30.22
Q1, Q2: 2N2222; TO-18-3
R1: 2,2M; R_Axial_DIN0207_L6.3mm_D2.5mm_P10.16mm_Horizontal
R2, R3: 33K; R_Axial_DIN0207_L6.3mm_D2.5mm_P10.16mm_Horizontal
R4: Voir Note 1; R_Axial_DIN0207_L6.3mm_D2.5mm_P10.16mm_Horizontal
RN1, RN3: R_Network04; R_Array_SIP5
RN2, RN4: R_Network08; R_Array_SIP9
SW1, SW3: SW_DIP_x04; DIP-8_W7.62mm_Socket
SW2, SW4: SW_DIP_x08; DIP-16_W7.62mm_Socket
U1, U6, U10: 4011; DIP-14_W7.62mm_Socket
U2, U7, U11: 4040; DIP-16_W7.62mm_Socket
U3: 4060; DIP-16_W7.62mm_Socket
U4, U9, U12: 4012; DIP-14_W7.62mm_Socket
U5: 4013; DIP-14_W7.62mm_Socket
U8, U13: 4068; DIP-14_W7.62mm_Socket
Y1: 32,768 kHz; Crystal_C26-LF_D2.1mm_L6.5mm_Vertical

Connections:
/1sec: JP1.3, JP2.3, U5.1 (Q), U7.10 (CLK)
/60sec: C20.2, JP1.1, JP2.1, U7.11 (Reset), U9.1
/500ms: U3.3 (Q14), U5.3 (C)
/&PA1-4: U1.13, U4.1
/&PA1-12: C18.2, U1.11, U6.1, U6.2, U6.8
/&PA5-12: U1.10, U1.12
/&PU1-4: U10.13, U12.1
/&PU5-12: U10.10, U10.12
/&PUA1-12: U6.5, U6.6, U6.13, U10.11
/CLK-PAUSE: JP2.2, U1.1
/CLK-PULSE: JP1.2, U10.1
/PA1: RN1.2 (R1), SW1.8, U4.9
/PA2: RN1.3 (R2), SW1.7, U4.10
/PA3: RN1.4 (R3), SW1.6, U4.11
/PA4: RN1.5 (R4), SW1.5, U4.12
/PA5: RN2.2 (R1), SW2.16, U8.11 (G)
/PA6: RN2.3 (R2), SW2.15, U8.12 (H)
/PA7: RN2.4 (R3), SW2.14, U8.9 (E)
/PA8: RN2.5 (R4), SW2.13, U8.10 (F)
/PA9: RN2.6 (R5), SW2.12, U8.5 (D)
/PA10: RN2.7 (R6), SW2.11, U8.4 (C)
/PA11: RN2.8 (R7), SW2.10, U8.3 (B)
/PA12: RN2.9 (R8), SW2.9, U8.2 (A)
/PAUSE_ENABLE: U1.2, U6.9, U6.11
/PU1: RN3.2 (R1), SW3.8, U12.9
/PU2: RN3.3 (R2), SW3.7, U12.10
/PU3: RN3.4 (R3), SW3.6, U12.11
/PU4: RN3.5 (R4), SW3.5, U12.12
/PU5: RN4.2 (R1), SW4.16, U13.11 (G)
/PU6: RN4.3 (R2), SW4.15, U13.12 (H)
/PU7: RN4.4 (R3), SW4.14, U13.9 (E)
/PU8: RN4.5 (R4), SW4.13, U13.10 (F)
/PU9: RN4.6 (R5), SW4.12, U13.5 (D)
/PU10: RN4.7 (R6), SW4.11, U13.4 (C)
/PU11: RN4.8 (R7), SW4.10, U13.3 (B)
/PU12: RN4.9 (R8), SW4.9, U13.2 (A)
/PULSE_ENABLE: R2.2, R3.2, U6.10, U6.12, U10.2
/RSTPA: C16.2, U2.11 (Reset), U6.3
/RSTPU: C17.2, U6.4, U11.11 (Reset)
GND: C1.1, C2.1, C3.1, C4.1, C5.1, C6.1, C7.1, C8.1, C9.1, C10.1, C11.1, C12.1, C13.1, C14.2, C15.2, C18.1, C19.2, D1.2 (A), J1.2, Q1.1 (E), Q2.1 (E), U1.7 (VSS), U2.8 (VSS), U3.8 (VSS), U3.12 (CL), U4.7 (VSS), U5.4 (R), U5.6 (S), U5.7 (VSS), U5.8 (S), U5.9 (D), U5.10 (R), U5.11 (C), U6.7 (VSS), U7.8 (VSS), U8.7 (Vss), U9.7 (VSS), U10.7 (VSS), U11.8 (VSS), U12.7 (VSS), U13.7 (Vss)
unnamed: 2A1.1, J2.1
unnamed: 2A1.2, K1.24
unnamed: 2A2.1, J2.3
unnamed: 2A2.2, K1.14
unnamed: C14.1, R1.1, U3.11 (/PH1), Y1.1
unnamed: C15.1, R1.2, U3.10 (PH0), Y1.2
unnamed: D2.1 (K), Q2.3 (C)
unnamed: D2.2 (A), R4.1
unnamed: D3.2 (A), K1.A1, Q1.3 (C)
unnamed: F1.1, J1.1
unnamed: J2.2, K1.21
unnamed: J2.4, K1.11
unnamed: Q1.2 (B), R2.1
unnamed: Q2.2 (B), R3.1
unnamed: SW1.1, U2.9 (Q0)
unnamed: SW1.2, U2.7 (Q1)
unnamed: SW1.3, U2.6 (Q2)
unnamed: SW1.4, U2.5 (Q3)
unnamed: SW2.1, U2.3 (Q4)
unnamed: SW2.2, U2.2 (Q5)
unnamed: SW2.3, U2.4 (Q6)
unnamed: SW2.4, U2.13 (Q7)
unnamed: SW2.5, U2.12 (Q8)
unnamed: SW2.6, U2.14 (Q9)
unnamed: SW2.7, U2.15 (Q10)
unnamed: SW2.8, U2.1 (Q11)
unnamed: SW3.1, U11.9 (Q0)
unnamed: SW3.2, U11.7 (Q1)
unnamed: SW3.3, U11.6 (Q2)
unnamed: SW3.4, U11.5 (Q3)
unnamed: SW4.1, U11.3 (Q4)
unnamed: SW4.2, U11.2 (Q5)
unnamed: SW4.3, U11.4 (Q6)
unnamed: SW4.4, U11.13 (Q7)
unnamed: SW4.5, U11.12 (Q8)
unnamed: SW4.6, U11.14 (Q9)
unnamed: SW4.7, U11.15 (Q10)
unnamed: SW4.8, U11.1 (Q11)
unnamed: U1.3, U1.5, U1.6
unnamed: U1.4, U2.10 (CLK)
unnamed: U1.8, U1.9, U8.13 (J)
unnamed: U4.2, U4.13
unnamed: U5.2 (~Q), U5.5 (D)
unnamed: U7.2 (Q5), U9.12
unnamed: U7.3 (Q4), U9.11
unnamed: U7.5 (Q3), U9.10
unnamed: U7.6 (Q2), U9.9
unnamed: U9.2, U9.13
unnamed: U10.3, U10.5, U10.6
unnamed: U10.4, U11.10 (CLK)
unnamed: U10.8, U10.9, U13.13 (J)
unnamed: U12.2, U12.13
VDD: C1.2, C2.2, C3.2, C4.2, C5.2, C6.2, C7.2, C8.2, C9.2, C10.2, C11.2, C12.2, C13.2, C16.1, C17.1, C19.1, C20.1, D1.1 (K), D3.1 (K), F1.2, K1.A2, R4.2, RN1.1 (common), RN2.1 (common), RN3.1 (common), RN4.1 (common), U1.14 (VDD), U2.16 (VDD), U3.16 (VCC), U4.3, U4.4, U4.5, U4.14 (VDD), U5.14 (VDD), U6.14 (VDD), U7.16 (VDD), U8.14 (Vdd), U9.3, U9.4, U9.5, U9.14 (VDD), U10.14 (VDD), U11.16 (VDD), U12.3, U12.4, U12.5, U12.14 (VDD), U13.14 (Vdd)

Notes on the sheet:
Base de temps 1 sec et 60 sec selection par cavalier
Inutilisé
Diviseur par 60
Selection horloge 1 sec ou 60 sec
Note 1 : R4 = 330 ohms sous 5V R4 = 1 Kohms sous 12V

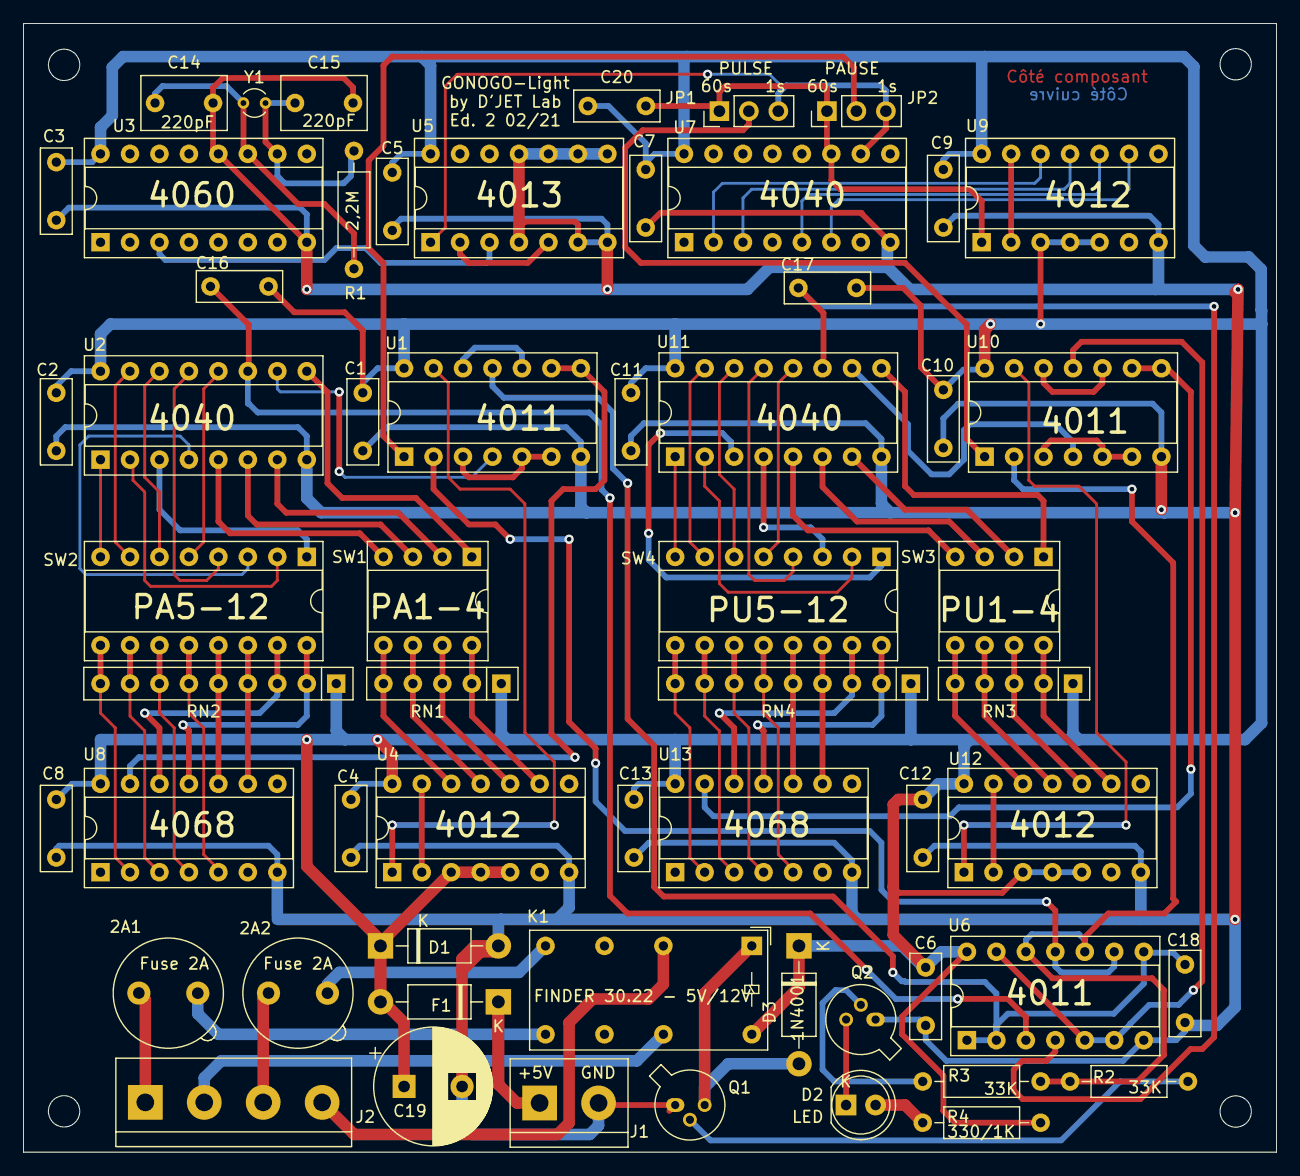
[picture p24: board timer-light.kicad_pcb from above]

Board: 2 copper layers, 108.0 x 97.3 mm, 59 parts (0 on the bottom side), 93 nets.
