duodiscus92/projet-gonogo/(commit log)

2021-02-07 ajout des fichiers source du programme gonogo-switch
2021-02-11 Correction d'une erreur dans le schéma et le pcb
    [timer-feuille1-v3.sch, timer-light.csv, timer-toplevel.csv, timer-toplevel.kicad_pcb]
2021-02-11 décalage des condensateurs 100nF dans pcb
    [timer-toplevel.kicad_pcb]
2021-02-23 correction des erreurs et ajout de capas de reset sur poweron
    [timer-feuille1-v3.sch, timer-light.kicad_pcb, timer-light.sch, timer-toplevel.kicad_pcb]
2022-09-14 ajout fichiers du projet gonogo upduino et publications
    [gonogo-upduino-B_Cu.gbr, gonogo-upduino-B_Mask.gbr, gonogo-upduino-B_Paste.gbr, gonogo-upduino-B_SilkS.gbr, gonogo-upduino-Edge_Cuts.gbr, gonogo-upduino-F_Cu.gbr, gonogo-upduino-F_Mask.gbr, gonogo-upduino-F_Paste.gbr]
